3jonah3/METR4810-Team2/STM32G431RBT6/Core/Src/main.c

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
/* Includes ------------------------------------------------------------------*/
#include "main.h"

/* USER CODE BEGIN Includes */
#include "motor.h"
#include "stepper.h"
#include "servo.h"
#include "switch.h"
/* USER CODE END Includes */

/* USER CODE BEGIN PD */
/* Change to 1 if DIR=0 travels away from SW4 on the assembled robot. */
#define DIR_TO_SWITCH4 0U
#define SWITCH_DEBOUNCE_MS 30U
/* Change this one value to adjust speed; period and pulse width follow it. */
#define STEPPER_STEP_HZ 500U
#define STEPPER_TIMER_HZ 1000000U
#if (STEPPER_STEP_HZ == 0U)
#error Step frequency must be nonzero
#elif ((STEPPER_TIMER_HZ / STEPPER_STEP_HZ) < 2U) || ((STEPPER_TIMER_HZ / STEPPER_STEP_HZ) > 65536U)
#error Step period must fit TIM16 and leave time for both high and low levels
#endif

/* USER CODE END PD */

ADC_HandleTypeDef hadc1;

TIM_HandleTypeDef htim1;
TIM_HandleTypeDef htim4;
TIM_HandleTypeDef htim16;

PCD_HandleTypeDef hpcd_USB_FS;

/* USER CODE BEGIN PV */
static uint8_t target_switch = 4U;
/* Both travel limits pressed together latches this fault until reset. */
static volatile uint8_t limit_fault = 0U;

/* USER CODE END PV */

void SystemClock_Config(void);
static void MX_GPIO_Init(void);
static void MX_ADC1_Init(void);
static void MX_USB_PCD_Init(void);
static void MX_TIM1_Init(void);
static void MX_TIM16_Init(void);
static void MX_TIM4_Init(void);
/* USER CODE BEGIN 0 */
static uint8_t StepperDirectionToTarget(void)
{
  return (target_switch == 4U) ? DIR_TO_SWITCH4 : (DIR_TO_SWITCH4 ^ 1U);
}


/* USER CODE END 0 */

/**
  * @brief  The application entry point.
  * @retval int
  */
int main(void)
{

  /* MCU Configuration--------------------------------------------------------*/

  /* Reset of all peripherals, Initializes the Flash interface and the Systick. */
  HAL_Init();

  /* Configure the system clock */
  SystemClock_Config();

  /* Initialize all configured peripherals */
  MX_GPIO_Init();
  while (HAL_GPIO_ReadPin(GPIOC, GPIO_PIN_11) == GPIO_PIN_SET)
  {
      HAL_Delay(1);
  }

  MX_ADC1_Init();
  // MX_USB_PCD_Init();  // USB hardware disabled for now.
  MX_TIM1_Init();
  MX_TIM16_Init();
  MX_TIM4_Init();
  /* USER CODE BEGIN 2 */

  Motor1_Init(&htim1);
  Motor1_SetDuty(100);
  Stepper1_Init(&htim16);

  Servo_Init(&htim4);
  servo(2, 20);  // Servo 2 to centre (1500 µs)
  /* Servo PWM is not started during this stepper test. */

  /* TIM16 counts at 1 MHz. Keep STEP high for half of each period. */
  const uint32_t step_period_ticks = STEPPER_TIMER_HZ / STEPPER_STEP_HZ;
  __HAL_TIM_SET_AUTORELOAD(&htim16, step_period_ticks - 1U);
  __HAL_TIM_SET_COMPARE(&htim16, TIM_CHANNEL_1, step_period_ticks / 2U);
  HAL_TIM_GenerateEvent(&htim16, TIM_EVENTSOURCE_UPDATE);

  /* Begin travel immediately after initialization; no start-button wait. */

  if (Switch_IsPressed(1) && Switch_IsPressed(4))
  {
    limit_fault = 1U;
  }
  else
  {
    /* If already at SW4, move away toward SW1. Otherwise seek SW4 first. */
    target_switch = Switch_IsPressed(4) ? 1U : 4U;
    Stepper1_Start(StepperDirectionToTarget());
  }
  /* USER CODE END 2 */

  /* Infinite loop */
  /* USER CODE BEGIN WHILE */
  while (1)
  {
    /* USER CODE END WHILE */

    /* USER CODE BEGIN 3 */
    if (!limit_fault)
    {
      if (Switch_IsPressed(1) && Switch_IsPressed(4))
      {
        Stepper1_Stop();
        limit_fault = 1U;
      }
      else if (Switch_IsPressed(target_switch))
      {
        /* Stop on the first press; debounce with the motor stopped. */
        Stepper1_Stop();
        HAL_Delay(SWITCH_DEBOUNCE_MS);

        if (Switch_IsPressed(1) && Switch_IsPressed(4))
        {
          limit_fault = 1U;
        }
        else
        {
          if (Switch_IsPressed(target_switch))
          {
            target_switch = (target_switch == 4U) ? 1U : 4U;
          }
          /* A false press resumes toward the SAME target, in either direction. */
          Stepper1_Start(StepperDirectionToTarget());
        }
      }
    }
    HAL_Delay(1);
  }
  /* USER CODE END 3 */
}

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
