3jonah3/METR4810-Team2/METR4810_Team2_code/METR4810_Team2_code.ioc

Mcu.UserName=STM32G431RBTx
PA0.Signal=S_TIM2_CH1
PA1.Signal=S_TIM2_CH2
PA10.Signal=S_TIM1_CH3
PA11.Signal=USB_DM
PA12.Signal=USB_DP
PA13.Signal=SYS_JTMS-SWDIO
PA14.Signal=SYS_JTCK-SWCLK
PA2.Signal=S_TIM2_CH3
PA3.Signal=S_TIM2_CH4
PA4.Signal=GPIO_Output
PA5.Signal=GPIO_Output
PA6.Signal=S_TIM3_CH1
PA8.Signal=S_TIM1_CH1
PA9.Signal=S_TIM1_CH2
PB0.Signal=S_TIM3_CH3
PB1.Signal=S_TIM3_CH4
PB10.Signal=USART3_TX
PB11.Signal=USART3_RX
PB12.Signal=GPIO_Output
PB13.Signal=GPIO_Output
PB14.Signal=S_TIM15_CH1
PB15.Signal=S_TIM15_CH2
PB2.Signal=GPIO_Output
PB3.Signal=GPIO_Output
PB4.Signal=S_TIM16_CH1
PB5.Signal=S_TIM17_CH1
PB6.Signal=S_TIM4_CH1
PB7.Signal=S_TIM4_CH2
PB9.Signal=GPIO_Output
PC0.Signal=ADC1_IN6
PC1.Signal=ADC1_IN7
PC10.Signal=GPIO_Input
PC11.Signal=GPIO_Input
PC12.Signal=GPIO_Input
PC13.Signal=GPIO_Input
PC14-OSC32_IN.Signal=GPIO_Input
PC15-OSC32_OUT.Signal=GPIO_Input
PC2.Signal=ADC1_IN8
PC3.Signal=GPIO_Input
PC4.Signal=USART1_TX
PC5.Signal=USART1_RX
PC6.Signal=S_TIM8_CH1
PC7.Signal=S_TIM8_CH2
PC8.Signal=I2C3_SCL
PC9.Signal=I2C3_SDA
PD2.Signal=GPIO_Input
PF1-OSC_OUT.Signal=GPIO_Output
