3jonah3/METR4810-Team2/(commit log)

2026-08-27 Added STM32 IDE files
2026-08-30 Updated PD2 pin
2026-08-30 Added LED PBA2, PBA3
2026-09-24 Blinking LED
2026-09-28 DC motor DC1 -Now working
2026-09-28 Steppers now working
2026-09-28 Servos added
2026-10-02 Stepper bounce working
2026-10-11 updated stepper speed
2026-10-11 fix start button
2026-10-14 Document demo sequence and test servo return path
2026-10-22 Rework the autonomous run: CAD steering, one cycle, pause and telemetry
    Servo 2 now follows the CAD steering schedule (Steering_schedule_from_CAD.csv,
    nominal 20 us per pod degree, straight at 90 deg) all the way out to SW1. The
    offset is capped at 23.4 deg because the keeper pocket only allows 23.5.
    Run changes:
    - One cycle per run: home to SW4, out to SW1, back to SW4, then stop.
    - Reverse only at the limit switches; there is no step-count limit.
    - A run that starts on SW4 backs off 1500 steps, checks that SW4 has
    released, then homes. If SW4 is still pressed a fault latches.
    - stop keeps the servo PWM running so the pod holds its angle. Cutting the
    PWM mid-pulse was throwing the serv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
2026-10-24 Updates to servo arc origin and servo arc range. Added a new function to set the servo arc range. Updated the README.md file to reflect the changes made to the servo control functions.
2026-10-24 Update run path, section speeds, and servo calibration
2026-10-25 Add calibrated two-cut run2 sequence and independent speed profile
2026-10-25 Remove Word report and draw.io flowcharts
