3jonah3/METR4810-Team2/(notices)

Notices in the files:
STM32G431RBT6/Core/Src/main.c:
Copyright (c) 2026 STMicroelectronics.
All rights reserved.
This software is licensed under terms that can be found in the LICENSE file
