3jonah3/METR4810-Team2/docs/images/Limit_switches.jpg

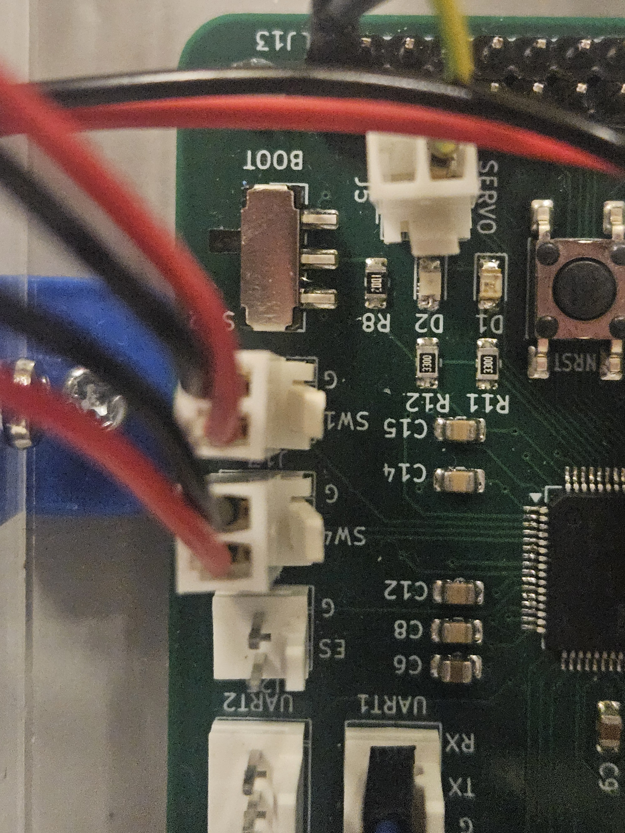
docs/images/Limit_switches.jpg
